justinBR/makehaven_iot_rfid_pcb/README.md

# makehaven_iot_rfid_pcb
connects together the components of the makehaven iot/rfid system
