justinBR/makehaven_iot_rfid_pcb/all_layers_image.png

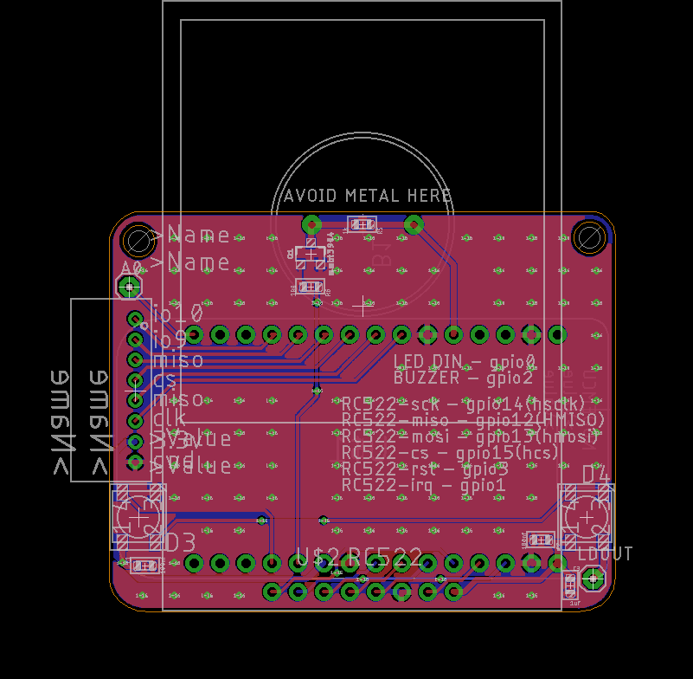
all_layers_image.png
