justinBR/makehaven_iot_rfid_pcb/dwarfid_2017-Nov-04_05-35-17PM-000_HOME_png.png

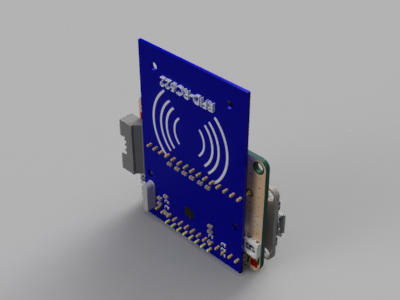
dwarfid_2017-Nov-04_05-35-17PM-000_HOME_png.png
