justinBR/makehaven_iot_rfid_pcb/schmatic.png

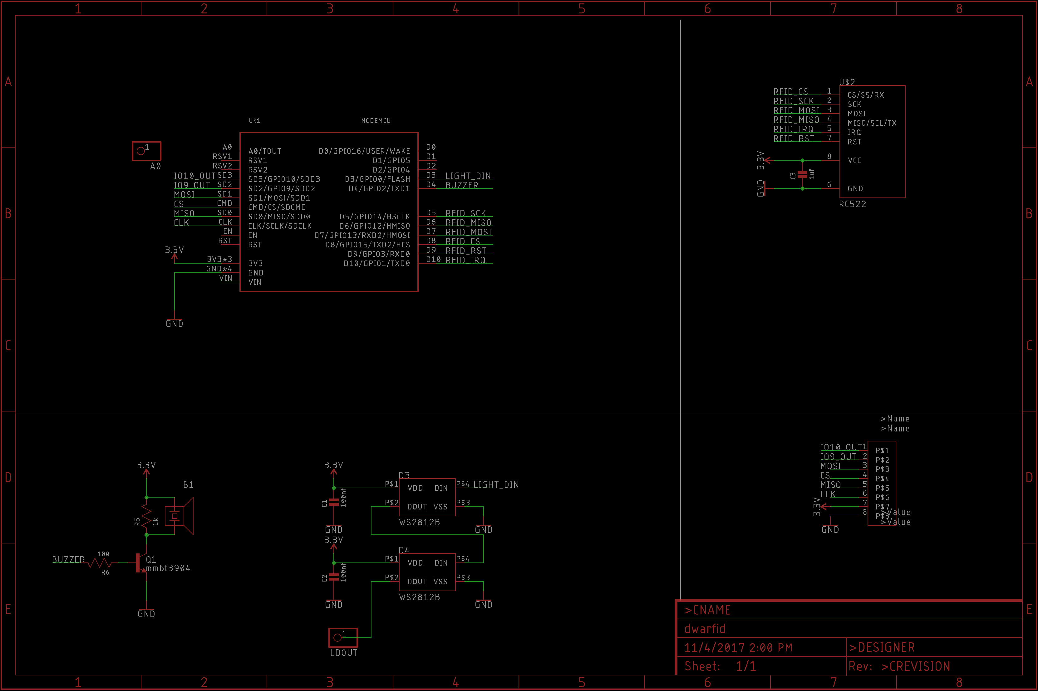
schmatic.png
