justinBR/makehaven_iot_rfid_pcb/dwarfid.brd

## EAGLE design dwarfid.brd (2017-11-04)

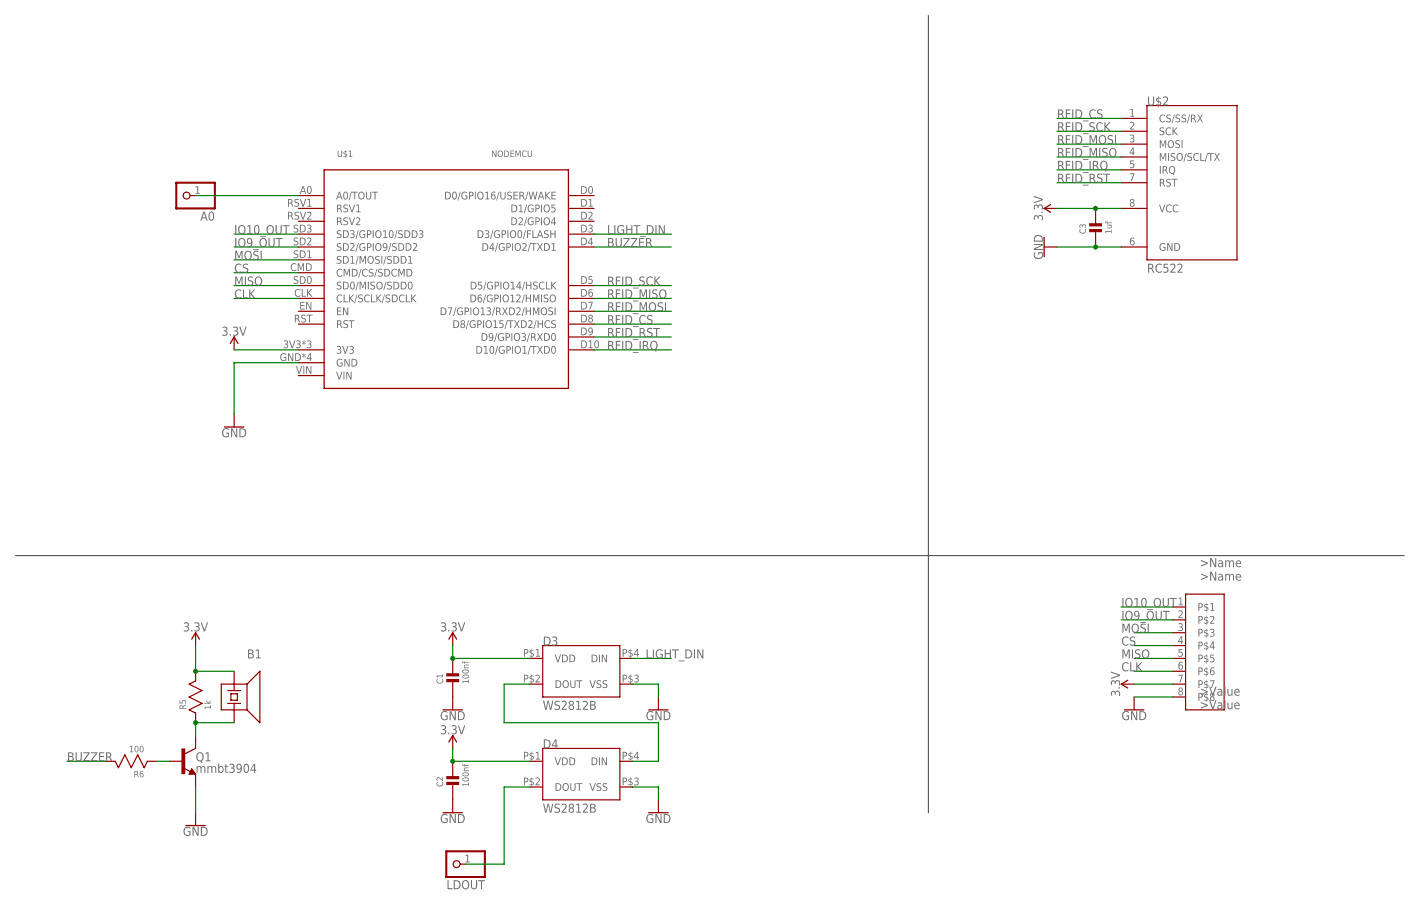
[picture p4: schematic dwarfid.sch]

Parts:
A0: PINHD-1X1; 1X01
B1: PS1720P02_PIEZO_BUZZER; PS1720P02_PIEZO
C1, C2: 100nf; PASSIVE_0603
C3: 1uf; PASSIVE_0603
D3, D4: WS2812B
LDOUT: PINHD-1X1; 1X01
Q1: mmbt3904; SOT23-3
R5: 1k; PASSIVE_0603
R6: 100; PASSIVE_0603
U$1: NODEMCU
U$2: RC522
U$3: JST8_2MM_RIGHTANGLE; JST_2MM_8POS

Connections:
3.3V: B1.P$1, C1.P$2, C2.P$2, C3.P$2, D3.P$1 (VDD), D4.P$1 (VDD), R5.P$2, U$1.3V3, U$1.3V3_2 (3V3), U$1.3V3_3 (3V3), U$2.8 (VCC), U$3.7
BUZZER: R6.P$2, U$1.D4 (D4/GPIO2/TXD1)
CLK: U$1.CLK (CLK/SCLK/SDCLK), U$3.6
CS: U$1.CMD (CMD/CS/SDCMD), U$3.4
GND: C1.P$1, C2.P$1, C3.P$1, D3.P$3 (VSS), D4.P$3 (VSS), Q1.2 (E), U$1.GND, U$1.GND2 (GND), U$1.GND3 (GND), U$1.GND4 (GND), U$2.6 (GND), U$3.8
IO9_OUT: U$1.SD2 (SD2/GPIO9/SDD2), U$3.2
IO10_OUT: U$1.SD3 (SD3/GPIO10/SDD3), U$3.1
LIGHT_DIN: D3.P$4 (DIN), U$1.D3 (D3/GPIO0/FLASH)
MISO: U$1.SD0 (SD0/MISO/SDD0), U$3.5
MOSI: U$1.SD1 (SD1/MOSI/SDD1), U$3.3
unnamed: D4.P$2 (DOUT), LDOUT.1
unnamed: B1.P$2, Q1.3 (C), R5.P$1
unnamed: D3.P$2 (DOUT), D4.P$4 (DIN)
unnamed: A0.1, U$1.A0 (A0/TOUT)
unnamed: Q1.1 (B), R6.P$1
RFID_CS: U$1.D8 (D8/GPIO15/TXD2/HCS), U$2.1 (CS/SS/RX)
RFID_IRQ: U$1.D10 (D10/GPIO1/TXD0), U$2.5 (IRQ)
RFID_MISO: U$1.D6 (D6/GPIO12/HMISO), U$2.4 (MISO/SCL/TX)
RFID_MOSI: U$1.D7 (D7/GPIO13/RXD2/HMOSI), U$2.3 (MOSI)
RFID_RST: U$1.D9 (D9/GPIO3/RXD0), U$2.7 (RST)
RFID_SCK: U$1.D5 (D5/GPIO14/HSCLK), U$2.2 (SCK)

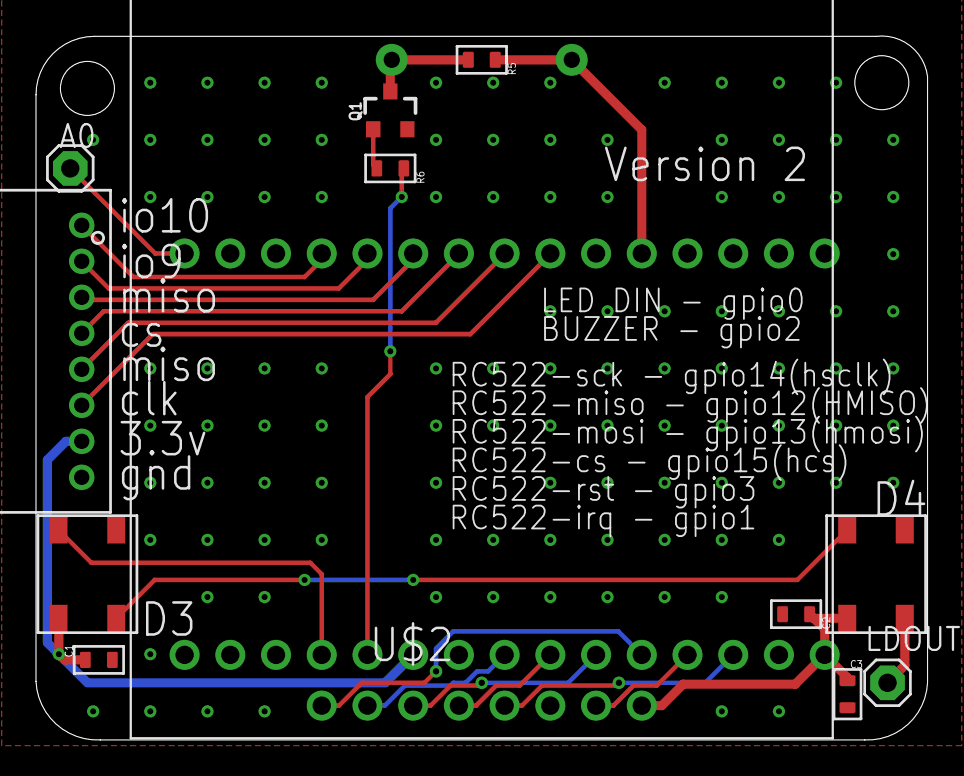
[picture p5: board dwarfid.brd from above]

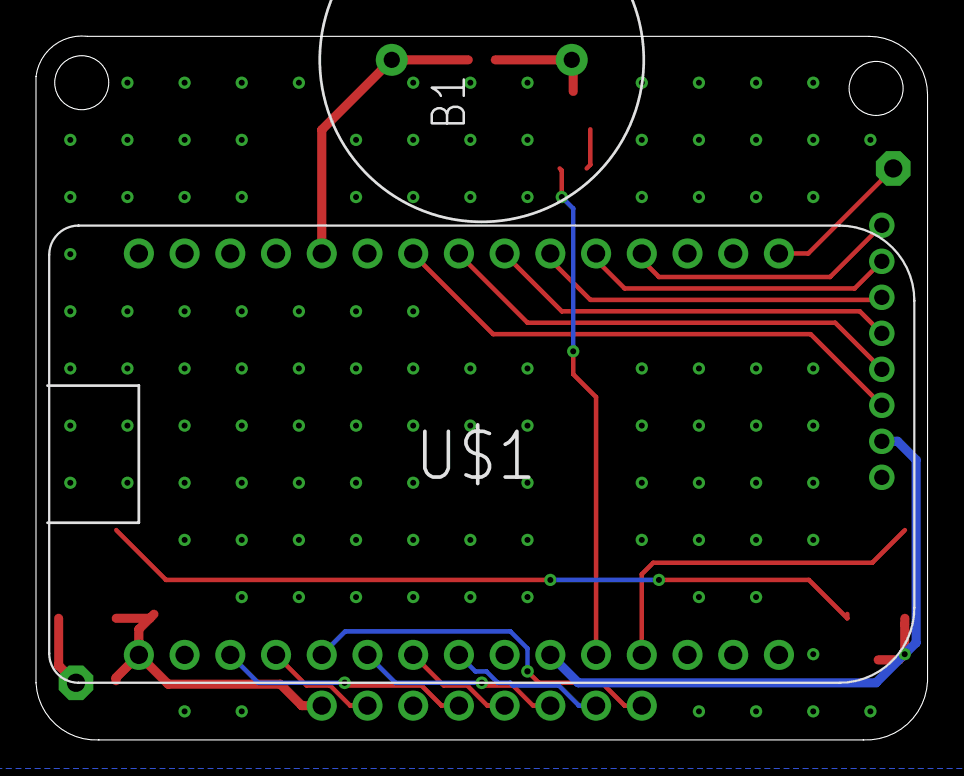
[picture p6: board dwarfid.brd from below]

Board: 2 copper layers, 49.5 x 39.1 mm, 14 parts (2 on the bottom side), 21 nets.
