justinBR/makehaven_iot_rfid_pcb/(threads)

Thread 1 (2017-10-21):

issues for revB

mhv-shared, 2017-10-21:
Just listing some things that can be changed for the next version

- resistor driving buzzer is too large, 100ohm works ok
- red LED driver was working but seems to have broken, not sure why. transistor is hot.
- should relocate LEDs towards bottom as they are blocked by card when reading
- PWM is not available on the current buzzer pin, should be moved to another pin such as D8.
- might be nice to use hardware SPI pins for RC522

justinBR, 2017-10-22:
Thanks for checking them out. Sorry I haven't been in to come by in the last few days to look at them.

Those LEDs were rated at a surprisingly high current and we are driving two in parallel. Even so, the currents should have been within the safe range for those transistors. I will try replacing the broken transistor and reducing the current to see if it survives after that.

The rest of the changes sound pretty straight forward. There is plenty of room for re-mapping the pins.

I was trying to keep the LEDs close to the place where the card would need to go, but there are other, better ways of showing people where to place the card. Moving the LEDs to the bottom sounds good to me.

thanks again!
