justinBR/makehaven_iot_rfid_pcb/(commit log)

2017-09-24 initial commit of makehaven iot rfid boards
    [dwarfid.brd, dwarfid.sch]
2017-09-24 added some images so that people without eagle can see the design at a glance.
    [dwarfid.brd]
2017-09-24 Create README.md
    Eagle pcb design files for makehaven card reader system.
    pins used for rc522:
    rfid_cs: gpio16
    rfid_sck: gpio5
    rfid_mosi: gpio4
    rfid_flash: gpio0
    rfid_rst: gpio2
    pin for red leds (active low): gpio9
    pin for green leds (active low): gpio10
    pin for buzzer (active high, likes to run at 2Khz): gpio 3
2017-10-27 fixed the spacing for the nodeMCU pins
    moved the LEDs to the bottom of the display
    Changed the current setting resistor for both the LEDs and the buzzer to 100 ohms.
    remapped the rfid card reader to use pins that can also be used as hardware spi pins.
    Put both the buzzer and the LEDs on pwm compatible pins
    replaced the 6pin jst connector with an 8pin connector.
    added the other hardware spi pins to the jst connector.
    [dwarfid.brd, dwarfid.sch]
2017-11-04 minor intermediate changed before switching out the LEDs for
    [dwarfid.brd, dwarfid.sch]
2017-11-04 replaced the LEDs with WS2812Bs.
    Moved the rfid board down so that it will be easier to solder.
    unfortunately both of these changes required us to increase the size of the board.
    [dwarfid.brd, dwarfid.sch]
2017-11-04 Moved the board up so that the bottom line is at y=0
    [dwarfid.brd]
2017-11-04 fixed a overlap error cause by moving the nodeMCU back a bit.
    [dwarfid.brd]
2017-11-04 fixed some weird errors in the silk screen that I think were caused by accidentally pulling from fusion360 earlier.
    [dwarfid.brd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]
2017-11-04 added a version number
    [dwarfid.brd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]
